bradrblack/sump-master-2000/hw/carrier-top.png

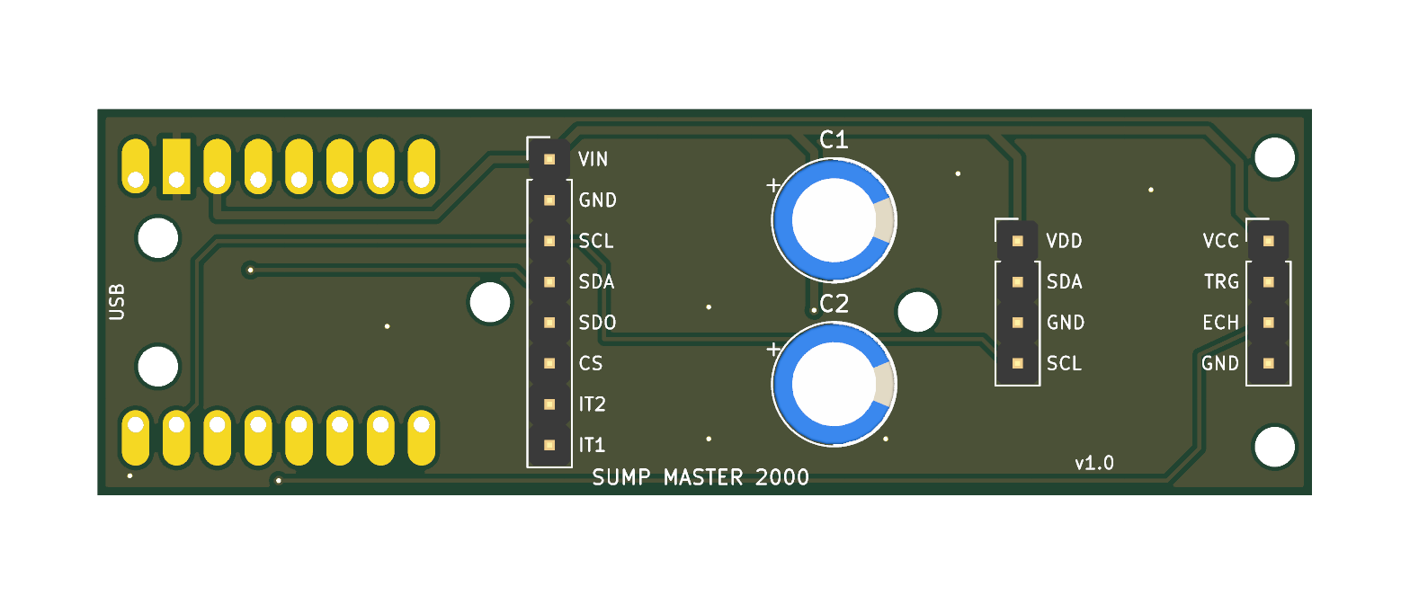
hw/carrier-top.png
