bradrblack/sump-master-2000/hw/case-preview.png

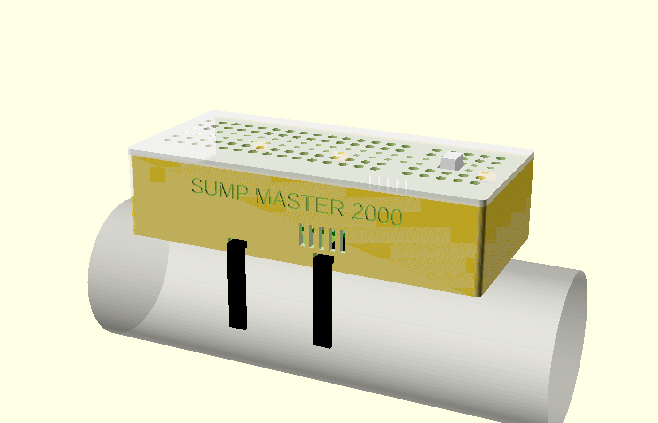
hw/case-preview.png
