bradrblack/sump-master-2000/hw/layout-sketch-v3.png

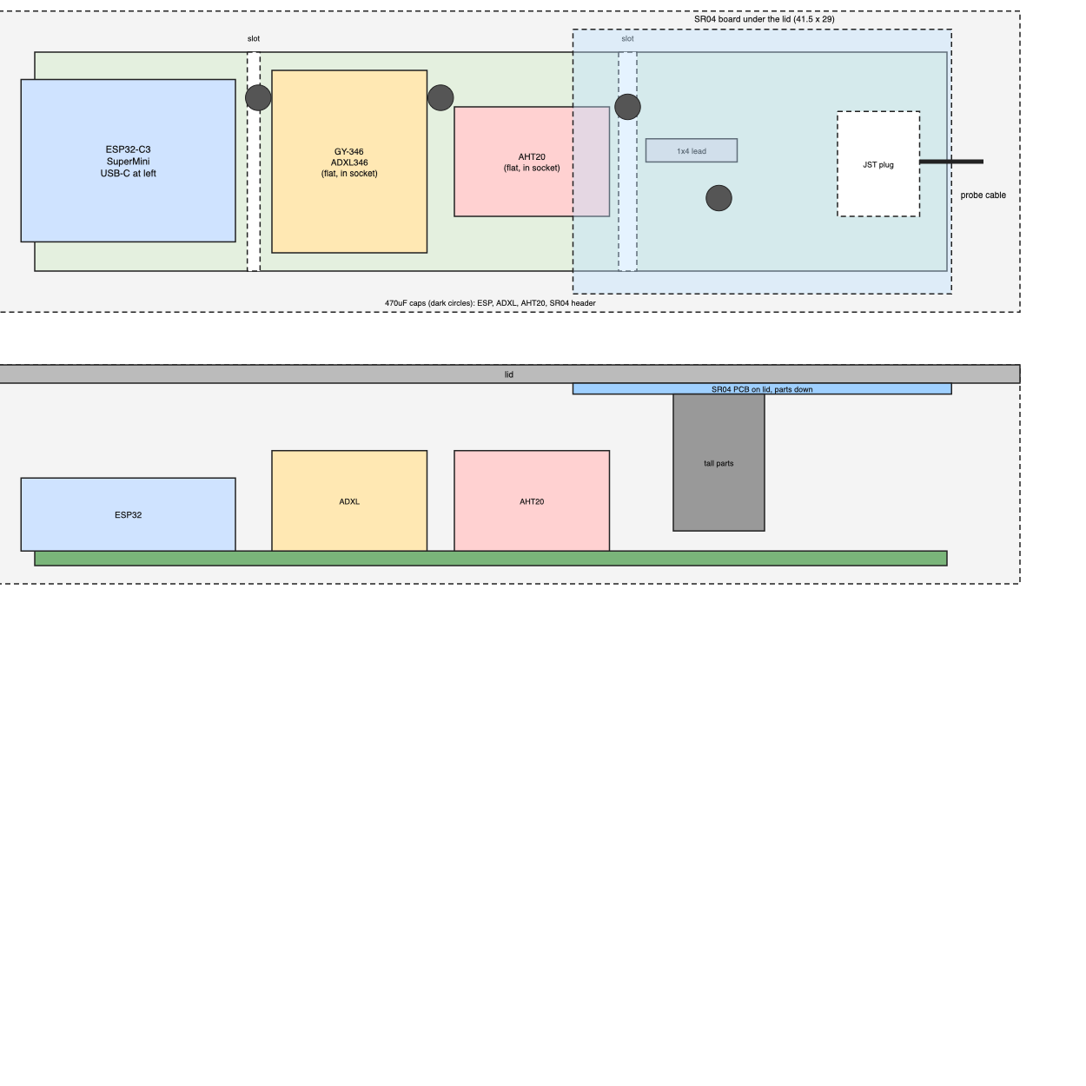
hw/layout-sketch-v3.png
