bradrblack/sump-master-2000/hw/ref/sr04-bottom.png

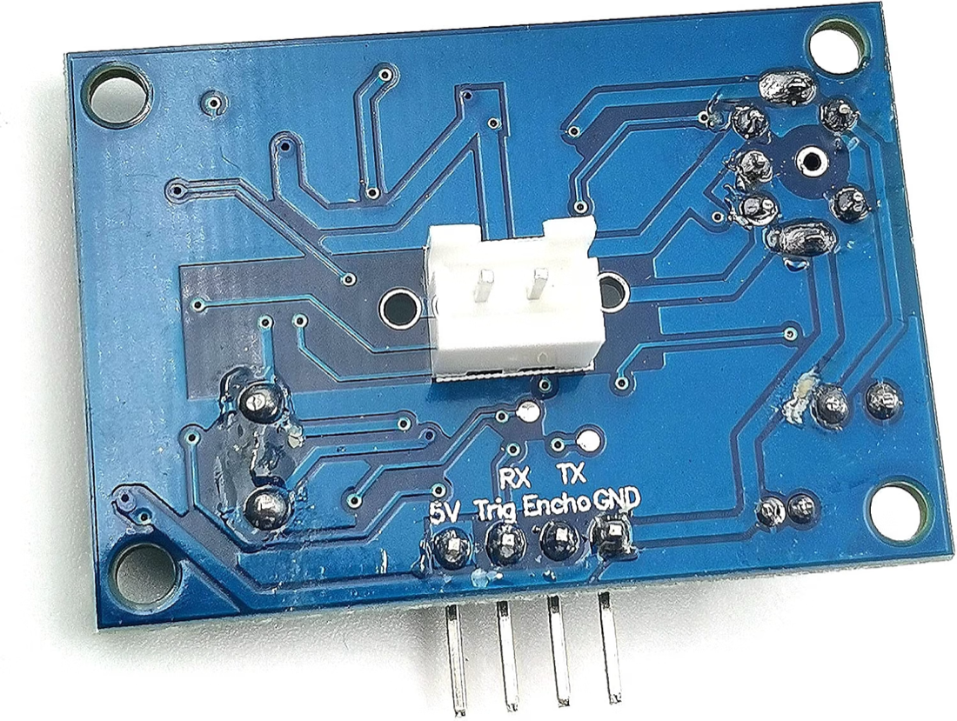
hw/ref/sr04-bottom.png
