bradrblack/sump-master-2000/hw/ref/sr04-top.png

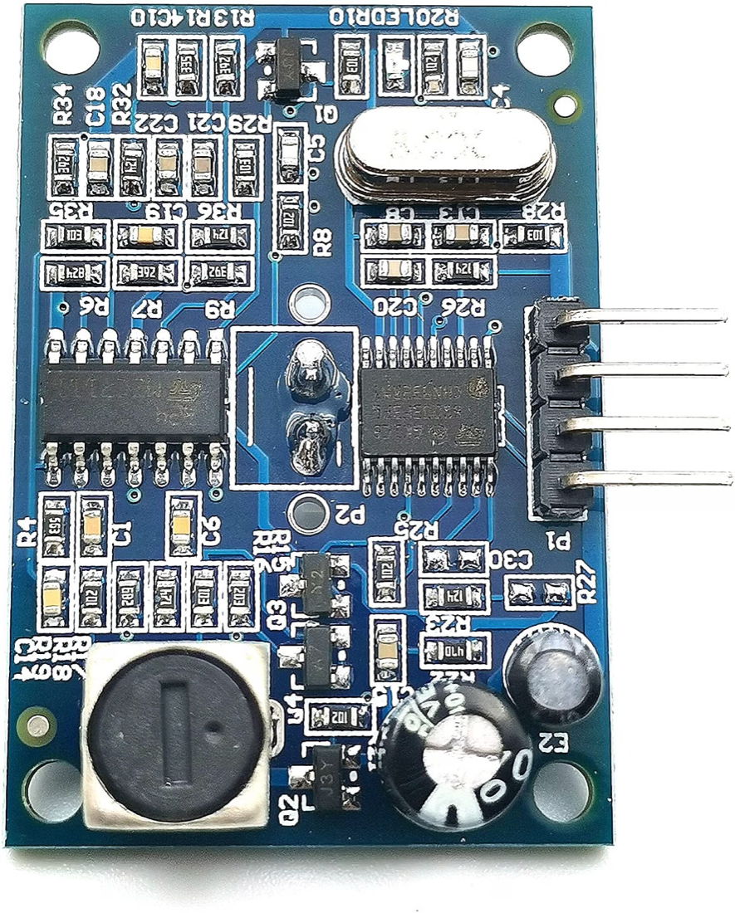
hw/ref/sr04-top.png
