bradrblack/sump-master-2000/hw/case/lid.stl

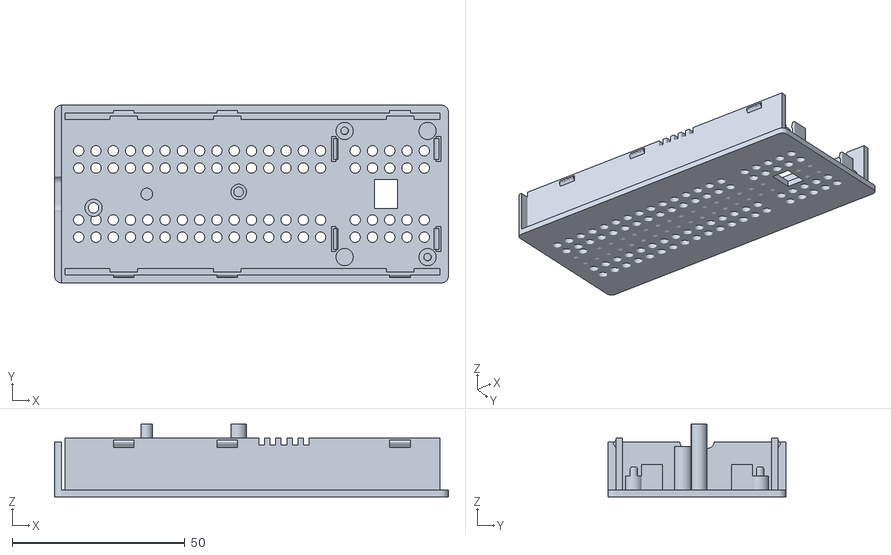
[picture p10: CAD file, 2026-11-12]
hw/case/lid.stl
114.0 x 51.4 x 21.1
