bradrblack/sump-master-2000/hw/case/tray.stl

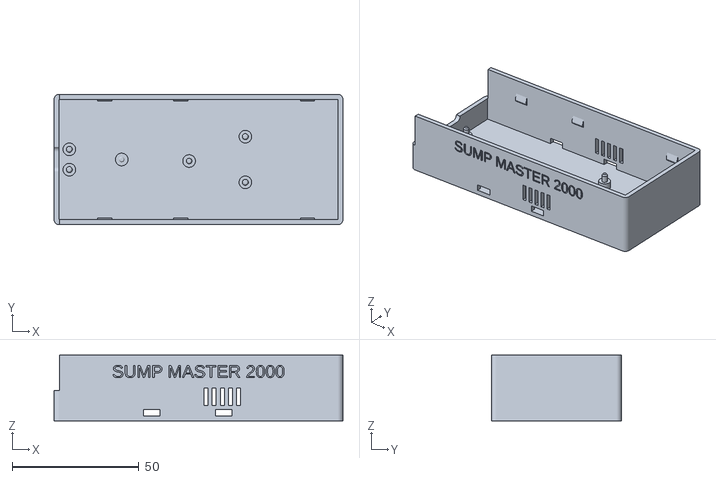
[picture p11: CAD file, 2026-11-11]
hw/case/tray.stl
114.0 x 51.4 x 26.0
