bradrblack/sump-master-2000/hw/sump_carrier.kicad_pcb

## KiCad design hw/sump_carrier.kicad_pcb (2026-11-08)

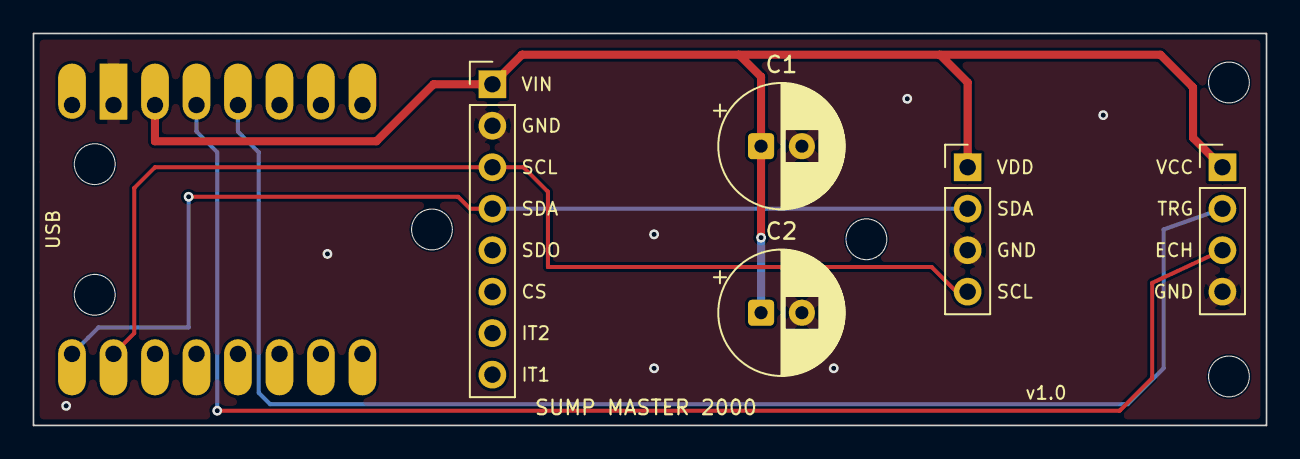
[picture p12: board sump_carrier.kicad_pcb from above]

Board: 2 copper layers, 75.5 x 24.0 mm, 12 parts (0 on the bottom side), 6 nets.

Parts:
C1: 470uF (ADXL); CP_Radial_D7.5mm_P2.50mm
C2: 470uF (AHT20); CP_Radial_D7.5mm_P2.50mm
H1, H2, H3, H4, H5, H6: pin; CasePin_Hole_2.5mm
J1: GY-346 ADXL346; PinHeader_1x08_P2.54mm_Vertical
J2: AHT20; PinHeader_1x04_P2.54mm_Vertical
J3: SR04 wires; PinHeader_1x04_P2.54mm_Vertical
U1: ESP32-C3_SuperMini; ESP32-C3_SuperMini_FaceUp

Connections:
/+3V3: C1.1, C2.1, J1.1, J2.1, J3.1, U1.3
/ECHO: J3.3, U1.4
/GND: C1.2, C2.2, J1.2, J2.3, J3.4, U1.2
/SCL: J1.3, J2.4, U1.10
/SDA: J1.4, J2.2, U1.9
/TRIG: J3.2, U1.5
