bradrblack/sump-master-2000/(commit log)

2026-09-23 Initial import: fork of vibration-monitor, plus design plan
    [sm2k.ino]
2026-09-23 Plan: JSN-SR04T on GPIO 3/4 with Echo voltage divider; default env sump
2026-09-23 Plan: JSN-SR04T wiring diagram, divider values and notes
2026-09-24 Plan: HTTP to Telegraf, real-time ntfy pump pushes, Grafana no-data alert, pit depth
2026-09-24 Plan: pump OFF push must include run time
2026-09-24 Firmware 2026-09-24r1: level, AHT20, Telegraf over HTTP, ntfy alarms, OTA with rollback
    Drop Adafruit IO. Add JSN-SR04T level and AHT20 drivers, line-protocol
    queue to Telegraf, queued ntfy pushes (real-time pump on/off with run
    time, high-water repeat, pump-didn't-lower-level, daily report), push
    OTA with health-checked rollback, and GY-346 (ADXL346) support.
    [aht20.cpp, aht20.h, jsn_sr04t.cpp, jsn_sr04t.h, sm2k.ino]
2026-09-24 Grafana sump dashboard and 'sump monitor silent' ntfy alert
    Dashboard generated by tools/make_dashboard.py (Flux): current values,
    pump/high-water timeline, water depth with pump on/off levels, run time
    and level drop per cycle, daily cycles/run time, temperature/humidity,
    cycle and event tables, annotations, board health. Alert provisioning
    fires via an ntfy webhook when no sump data arrives for 30 minutes.
    Replaces the old appliance-monitor dashboard.
2026-09-24 Firmware 2026-09-24r2: run without the accelerometer
    A missing or failed accelerometer no longer blocks boot or reboots the
    board: pump detection pauses, level/alarms/reporting/OTA continue, one
    ntfy alert, retried every 30 s with I2C bus recovery.
    [sm2k.ino]
2026-09-24 Firmware 2026-09-24r3: quieter logs for missing sensors, named Telegraf errors
    [sm2k.ino]
2026-09-24 Dashboard: back to one dual-axis board health panel
    Reverts 221ada6.
2026-11-08 Firmware 2026-11-08r4: NeoPixel status LED, I2C bring-up fixes, PCB design brief
    - NeoPixel on GPIO 8 (green all clear, blue pump running, red high water)
    - I2C at 100 kHz, boot-time accelerometer retry with bus restart
    - JSN Echo pull-down; level sensor on 3.3 V without divider
    - Remove bench diagnostics, restore 15 dBm TX power
    - Grafana/ntfy docs fix; notes and changelog updated
    - hw/: design brief, sketches and reference photos for the carrier PCB
    Claude-Session: https://claude.ai/code/session_019Ex3Rf3LCidXNUXiVGQhAM
2026-11-08 Status LED: flash red/purple for high water (pump off/on)
    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
2026-11-08 Docs: update README, PLAN and NOTES for the new wiring (3.3 V JSN, caps, NeoPixel)
    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
2026-11-08 Hardware: carrier PCB v1.0 and printed case
    Carrier PCB (hw/sump_carrier.kicad_*, generated by hw/tools/gen_carrier.py):
    75.5 x 24 mm, 2 layers, through-hole only, ERC/DRC clean. ESP32-C3
    SuperMini, GY-346 and AHT20 soldered on their own headers, two 470 uF
    caps, J3 pads for the SR04 Dupont wires, six 2.5 mm case-pin holes
    (two under the ESP for USB support). Bottom silkscreen: BB logo,
    project URL and "PCB v1.0".
    Case (hw/case/sump_case.scad -> tray.stl, lid.stl): 114 x 47 x 28 mm.
    Tray with pin standoffs, curved USB-C opening, AHT20 vents, and strap
    rails with a channel that sits on the 1-1/2" ABS outlet pipe. Lid with
    vent-hole grid, RESET button tunnel, and the AJ-SR04M snapped undernea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
2026-11-08 Hardware: carrier PCB v1.0 Gerbers and drill files
    hw/gerbers/ (copper, mask, silkscreen, edge cuts; Excellon drills in mm,
    plated and non-plated separate, with drill maps) and the same files zipped
    for upload: hw/sump_carrier-v1.0-gerbers.zip.
    Claude-Session: https://claude.ai/code/session_019Ex3RgFFaxY7rNwSt54uB4
2026-11-08 Firmware 2026-11-08r5, docs cleanup, beginner InfluxDB/Telegraf/Grafana guide
    - Accelerometer: failed reads count as no signal and as strikes; measure-mode
    and constant-signal checks; burst read
    - AHT20 quick retries after a failed read
    - First level reading after boot must be confirmed
    - README: setup guide for InfluxDB, Telegraf and Grafana; drop personal and
    historical references; clarify Wi-Fi TX power is only for older boards
    - PLAN: refresh status, remove fork/Adafruit IO history
    - Telegraf output URL from INFLUX_URL; placeholder Telegraf URL in secrets example
    Claude-Session: https://claude.ai/code/session_019Ex3Rf3LCidXNU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
2026-11-10 Case: flat tray underside, zip ties through side-wall slots
    The rails, strap tunnels and pipe channel under the tray meant it could
    not sit flat on the print bed. The ties now enter through slots low in
    the side walls and cross the floor under the carrier, where the board
    has no solder tails. The floor vent slots under the AHT20 are removed
    too, so the underside is solid.
    Claude-Session: https://claude.ai/code/session_01NKgmVcdSJ856DA9pQskzrV
2026-11-11 Case: skirt closure replaces the snap lip; solid H1 clamp post
    The lid's 1.2 mm snap lip was modelled beside the lid wall with no
    overlap, so it was a separate body and did not print. The closure now
    follows the fan dongle case: full-height tray walls, a flat lid with
    two 2 mm skirts and snap tabs inside them, and a lid end wall over a
    low stub wall at the USB end. The case is 4.4 mm wider (51.4 mm) and
    the label moves to the tray. The lip variant is removed.
    The H1 clamp post's hollow tip had a 0.3 mm wall that did not print;
    the post is now solid and the tray pin under it stops below the board's
    top face. Posts and snap ridges overlap their parent part, so each STL
    is one body.
    Co-Author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
2026-11-11 Firmware 2026-11-11r2: web page, settings in NVS, vibration to InfluxDB
    The board now serves a page at http://sm2k.local/ with live pump state,
    vibration (charted against the thresholds), water depth, air readings,
    calibration readings, the recent log and a settings form, so it can be
    watched and calibrated from a phone once it is in the pit.
    The eight calibration values (vibration thresholds, confirm times,
    sensor-to-floor distance, high-water depth and clear distance, expected
    drop) are saved in NVS and changeable from the page with digest
    authentication; the platformio.ini flags are now the defaults.
    The 10-minute reading adds idle and running vibration and the
    thresholds in force, and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
2026-11-11 Firmware 2026-11-11r3: web page HIGH WATER badge cleared with the alarm
    The badge's CSS display rule overrode the hidden attribute, so it stayed
    on the page after the alarm cleared. The board's state and LED were
    right; only the page was wrong.
    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
2026-11-12 Firmware 2026-11-11r4: Home Assistant over MQTT, connections on the web page
    With an MQTT broker set, the board publishes a retained state message,
    an online/offline status (last will) and Home Assistant MQTT Discovery
    for 13 entities under one device. InfluxDB, ntfy and MQTT are each
    optional.
    The web page gains a Connections form (Telegraf address, ntfy topic,
    MQTT broker and login, admin password), saved in NVS and applied
    without a restart. secrets.h is now optional and only supplies starting
    values; the admin password starts as the OTA password.
    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
2026-11-12 Case: friction-fit skirts replace the slit snap tabs
    The lid skirts had three slit tabs per side, 1 mm thick with a window
    cut through each, which are fragile. The skirts are now unbroken, as
    on the fan dongle case (rf-ceiling-fan-remote): at each of the same
    three positions per side the skirt is thinned from the inside to a
    1 mm, 8 mm wide pocket framed by the full 2 mm skirt, and a low wedge
    ridge on the tray wall (10 mm wide, 0.3 mm interference) presses on it,
    so the lid is held by friction. No slits, windows or free tabs.
    Only the skirts and the tray's ridges change; every other surface of
    both parts is identical (checked by boolean difference of the old and
    new STLs). part="clash" now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
2026-11-12 Case: rounded click detents on the lid skirts instead of friction ridges
    Each 1 mm skirt pocket now carries a rounded bump (35 deg flanks, 6 mm
    wide) near the skirt's lower edge that clicks into a matching rounded
    seat in the tray wall (0.5 mm deep). Closing flexes the pocket 0.4 mm
    while the bump rides down the wall; closed, there is 0.1 mm clearance,
    so nothing is preloaded and the fit doesn't creep loose. The tray's
    wedge ridges are removed. detent sets the overlap.
    Checked: part="clash" is empty; the lid raised 5 mm overlaps the tray
    only at the six bumps (0.4 mm); old vs new STLs differ only at the six
    closure spots.
    Claude-Sessi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
